Aidan-OS/Mochi40/Blender Files/Renders/Liquorice.png

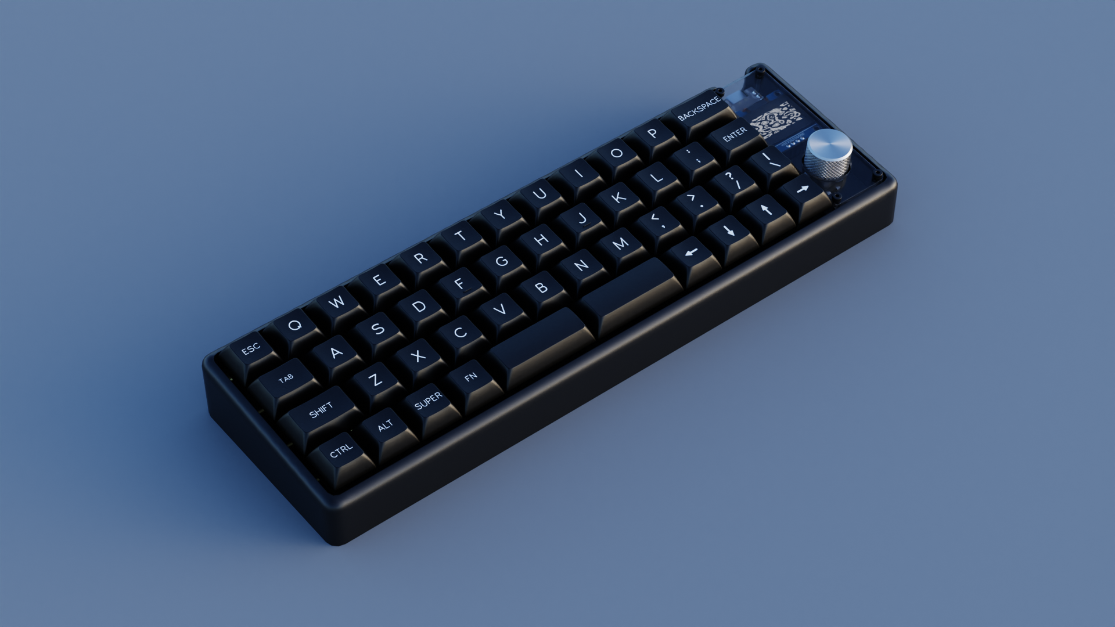
Blender Files/Renders/Liquorice.png
