Aidan-OS/Mochi40/Blender Files/Renders/Matcha.png

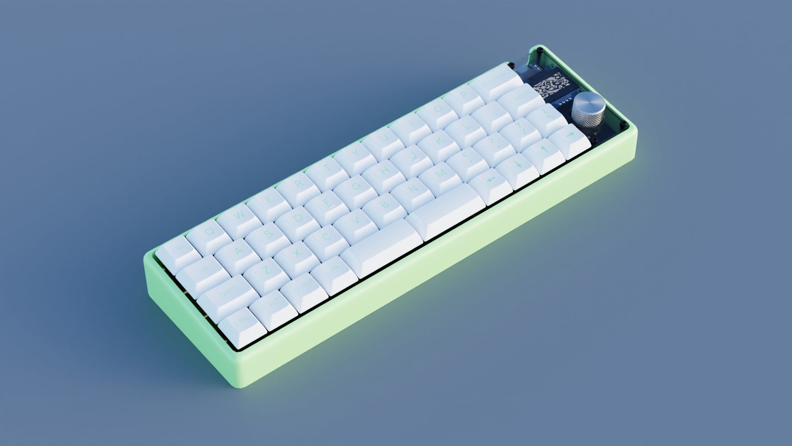
Blender Files/Renders/Matcha.png
