Aidan-OS/Mochi40/ic.md

Subject: Mochi40: A Burger Mounted 40% with a Knob, OLED, and optional Bluetooth

[font=arial][center][size=14pt]Hello Geekhack, today I present you the[/size]
[color=purple][size=36pt]Mochi40[/size][/color]

[img]https://i.imgur.com/1u3vPoi.png[/img]
Mochi40 (Taro Colourway)

[size=18pt][color=red][b]Disclaimer:[/b][/color][/size]
[size=12pt]The Mochi40 is based off of the Whimsy, a board designed by Prkns that was meant to go into group buy around a year ago. After Prkns went silent for almost 4 months, I began to reverse engineer the Whimsy through the renders and the files publicly available on GitHub. After building a small following on the ThisIsFourteen server, I moved to my own server and began to differentiate my project from the Whimsy. Additionally, all the files I have created are publicly available on GitHub under a permissible license to keep with the open source nature of the project: [url]https://github.com/Aidan-OS/Mochi40[/url]

Prkns still hasn't directly communicated with his community, however one of his moderators has communicated for him stating that he does not know when he will be able to return to the world of keyboards. As a result I continued to develop the Mochi40.

How does the Mochi40 differentiate itself from the Whimsy? Well, the title of the post gives some of it away, but let's get into it![/size]

[color=purple][size=18pt]Case Material and Colours[/size][/color]

[size=12pt]The Mochi40 will be made of 6063 aluminum and exclusively treated with Cerakote. There are currently 8 colour options shown below. I am in close contact with my coating shop and have confirmed that all of these colours will be okay to do, provided a minimum order of 10 per colour. If I get very little to no interest on a colour it will be dropped, but other than that all these colours will be run. Additionally, I am in midst of working with the shop to get basic prototype testing of each of the mixed colours on scrap material.[/size]

[img]https://i.imgur.com/1u3vPoi.png[/img] [img]https://i.imgur.com/ApZ9prn.png[/img]
Taro (Bright Purple + Stormtrooper White mix)                                                                                       Butterfly Tea (It's a Boy Blue)
[img]https://i.imgur.com/UucUkbZ.png[/img] [img]https://i.imgur.com/Sz2EtNh.png[/img]
Liquorice (Blackout Black)                                                                                                 Matcha (Mojito Green + Stormtrooper White mix)
[img]https://i.imgur.com/DThFcTM.png[/img] [img]https://i.imgur.com/qVN6Caj.png[/img]
Plain (Stormtrooper White)                                                                                                                   Red Bean (Crimson)
[img]https://i.imgur.com/2JMorvx.png[/img] [img]https://i.imgur.com/JZZRiYR.png[/img]
Strawberry (Bazooka Pink)                                                                                                       Waterdrop (Ceramic High Gloss Clear)

[color=purple][size=18pt]Plate Materials [/size][/color]

[size=12pt]Currently I am confident in offering FR4, PC, POM, and aluminum plates. I have done work to find a place which will provide brass plates at a reasonable price, however have been out of luck. Brass is still included on the IC, however unless there is a considerable amount of interest in it (and people are willing to pay a premium) I will not be offering brass.[/size]

[color=purple][size=18pt]PCB & Layout[/size][/color]

[size=12pt]The core of the Mochi40 is the fine!40 PCB. There will be two options for the fine!40 rev1, a soldered and a hotswap version.

The soldered version of the PCB will require you to solder everything: the diodes, the microcontroller, the OLED, the rotary encoder, the reset button, and the switches.

The hotswap version will still require you to solder the microcontroller, OLED, the reset button, and Rotary Encoder, but not the diodes and switches.

Below is an image featuring the available layouts on the fine!40 soldered PCB. As for the Hotswap PCB, the only available layout will be L1. I am currently considering switching L1 to be 2.25u + 2.75u, so that is included on the IC.[/size]

[img]https://i.imgur.com/CSch6fS.png[/img]
Mochi40 Layout Options

[color=purple][size=18pt]Microcontrollers, OLEDs, & Firmware[/size][/color]

[size=12pt]The fine!40 pcb is capable of functioning with two different microcontrollers, the nice!nano and the Elite-C. I will be providing both as options at group buy time, with the nice!nano being slightly more expensive and including a JST header for your battery. Doing things in this manner allows for me to offer a bluetooth upgrade at as low of a cost as possible.

I will be offering two different sizes of SSD1306 OLED at the time of the group buy, 128x64 and 32x6, both with white lighting. 

As for firmware, the Elite-C version will use QMK, while the nice!nano will use ZMK.[/size]

[color=purple][size=18pt]Purchase Options[/size][/color]
[size=12pt]I really wish I could work out a way to make this less complicated of a breakdown, but I just can't. There will be two core purchasing options, the Mochi40 Kit and the fine!40 PCB.[/size]

[size=12pt]
[u]Mochi40 Kit[/u]
[i]Required Parts[/i]
1 x Aluminum Case (any colour)
1 x fine!40 PCB (Soldered or Hotswap)
1 x Core electronics kit (diodes, rotary encoder, reset button)
1 x Core mounting kit (screws, 50A Silicone o-rings)
1 x OLED (128x64, 128x32)
1 x Microcontroller (Elite-C or nice!nano)
1 x Acrylic Screen Cover

[i]Optional Parts[/i]
1 x Plate & Plate Foam (yes this can be built plateless)
1 x JST battery connector (for nice!nano)

[u]fine!40 PCB[/u]
[i]Required Parts[/i]
1 x fine!40 PCB (Soldered or Hotswap)
1 x Core electronics kit (diodes, rotary encoder, reset button)
1 x Microcontroller (Elite-C or nice!nano)
1 x Core mounting kit (screws, 50A Silicone o-rings)
1 x OLED (128x64, 128x32)
1 x Acrylic Screen Cover
 
[i]Optional Parts[/i]
1 x JST Battery connector
1 x Plastic mounting kit (Threaded inserts for 3D printed cases)

[u]Extra Parts for Individual Purchase[/u]
- All plates
- Extra Microcontrollers
- Extra Acrylic Screen Covers
- Extra OLED Screens
- Plate Foam
[/size]

[color=purple][size=18pt]Vendors and Pricing[/size][/color]
[size=12pt]NA: Me (Located in Toronto, Canada)
UK: Protozoa
EU: CandyKeys
AUS: Allcaps
SEA: Hex Keyboards
India: TBD
Japan: TBD

Pricing per vendor differs more than just the currency conversion. This is due to the costs associated with vendors. If you are ordering from an area where a vendor sells, you are going to save money on shipping and taxes as a result.

[img]https://i.imgur.com/znM21WO.jpg[/img]
[/size]

[color=purple][size=18pt]Prototype(s)[/size][/color]
[size=12pt]In this day and age you can't really come to GH without a prototype it seems, so I have done so. My first prototype is of a slightly older case design with the only major change being the removal of the center screw post.

[img]https://i.imgur.com/uzo8PA6.jpg[/img] [img]https://i.imgur.com/0qNttD1.jpg[/img] [img]https://i.imgur.com/8msYtKK.jpg[/img]

[img]https://i.imgur.com/kVi3sCo.jpg[/img] [img]https://i.imgur.com/WfhExhh.jpg[/img] [img]https://i.imgur.com/Sc0cegF.jpg[/img]

The prototype definitely has some issues to address, all of which should be fixed in the second prototype I am currently having made. First, there are some small holes in the bottom of the case as a result of tolerance issues. Second there is clear ringing on some of the outside edges of the case which will not be present in the final versions by adding another finishing pass. Finally, there are two spots where the coating is rough as a result of the hanger rubbing against the board while drying. This will be solved with a custom drying rig for the final product.

One more thing to comment on is the thin coating on bottom inside edges of the case. This is a result of an intentional cost cutting measure that has been done to bring the board out for a lower price. This thinner coating will only be present on the bottom inside of the case (where it is not visible when built).[/size]

[color=purple][size=18pt]My Thanks to the Community[/size][/color]
[size=12pt]I have a large list of people to say thanks to as a result of the fantastic support that I have gotten from many discords. Heck, I wouldn't be here if it weren't for the OGs on my discord server who have been helping every step of the way with feedback and design input. They pushed me to turn this into a full project instead of just making a Whimsy for myself. Please note that this list of thanks is in absolutely no order:

Bomtarnes from the QMK Discord
Filterpaper from the QMK Discord
Drashna from the QMK Discord
Dan from RingerKeys
Pete Johanson of ZMK
BraveKarma of the ZMK Discord
Maple Computing of the Elite-C Project
Nick of Nice Keyboards
Ecto of Protozoa
MakerJake
FreshFromTheGrave
JC of Allcaps
David of CandyKeys
Jaspertandy of Fourteen
Prkns of Fourteen
Everyone on the AidanSmith.dev Discord
[/size]
[size=24pt]
[URL=https://forms.gle/RMZY9wcHToaioVtB6]Interest Check Form[/URL]
[URL=https://discord.gg/kkPBkA3x4q]Discord[/URL]
[/size]
[/center]
