Aidan-OS/Mochi40/Blender Files/Renders/Jpgs/Plain.jpg

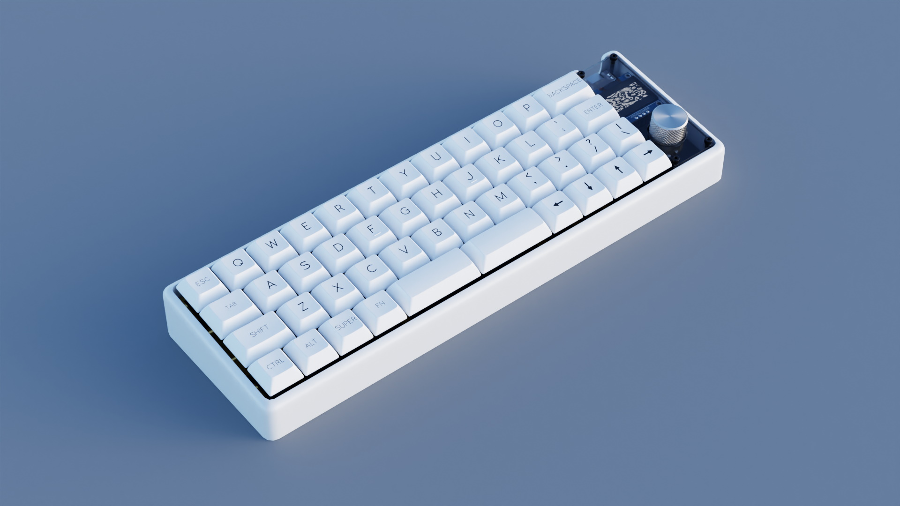
Blender Files/Renders/Jpgs/Plain.jpg
