Aidan-OS/Mochi40/Blender Files/Renders/Jpgs/Red Bean.jpg

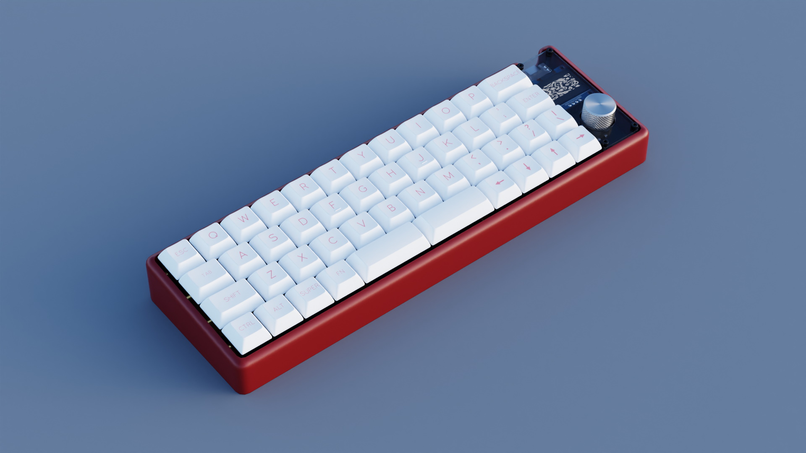
Blender Files/Renders/Jpgs/Red Bean.jpg
