Aidan-OS/Mochi40/Blender Files/Renders/Jpgs/Strawberry.jpg

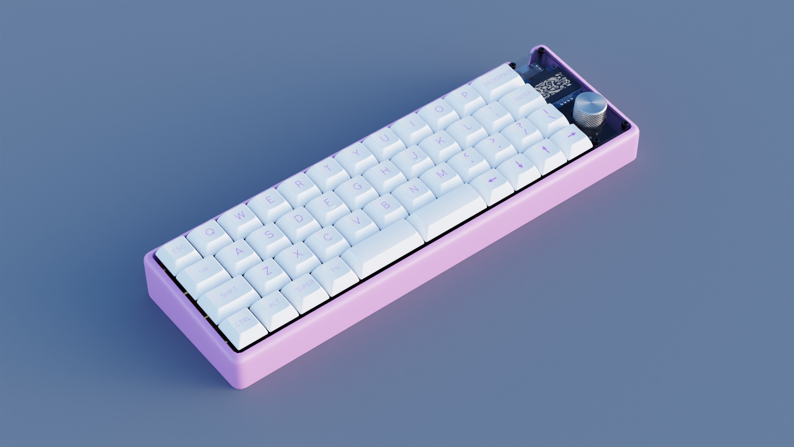
Blender Files/Renders/Jpgs/Strawberry.jpg
