Aidan-OS/Mochi40/Blender Files/Renders/Jpgs/Taro.jpg

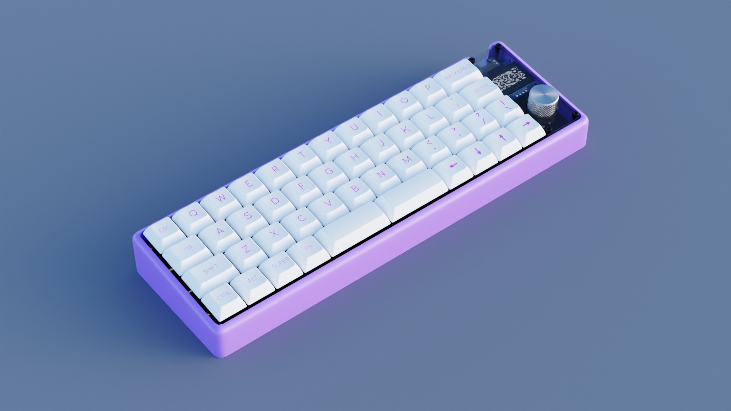
Blender Files/Renders/Jpgs/Taro.jpg
