Aidan-OS/Mochi40/Blender Files/Renders/Jpgs/Tea + Taro.jpg

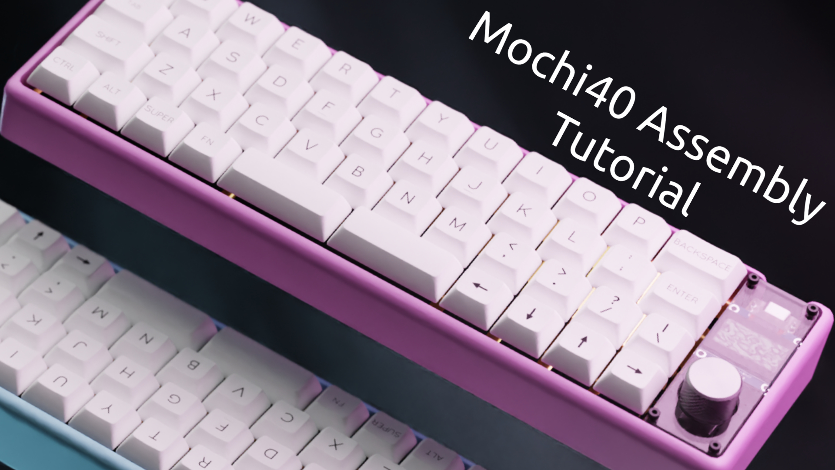
Blender Files/Renders/Jpgs/Tea + Taro.jpg
