Aidan-OS/Mochi40/Blender Files/Renders/Jpgs/Waterdrop.jpg

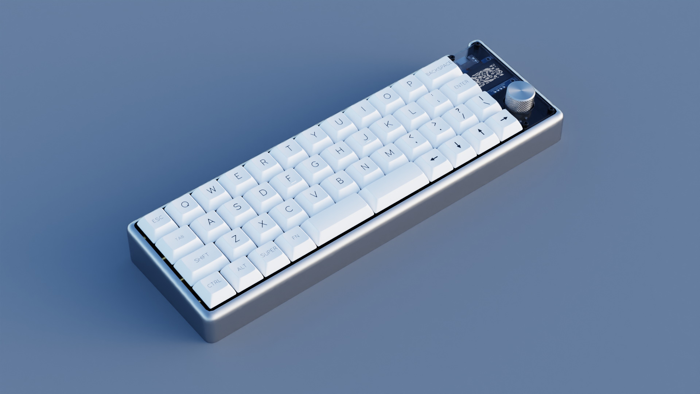
Blender Files/Renders/Jpgs/Waterdrop.jpg
