Aidan-OS/Mochi40/Blender Files/Renders/Tea + Taro.png

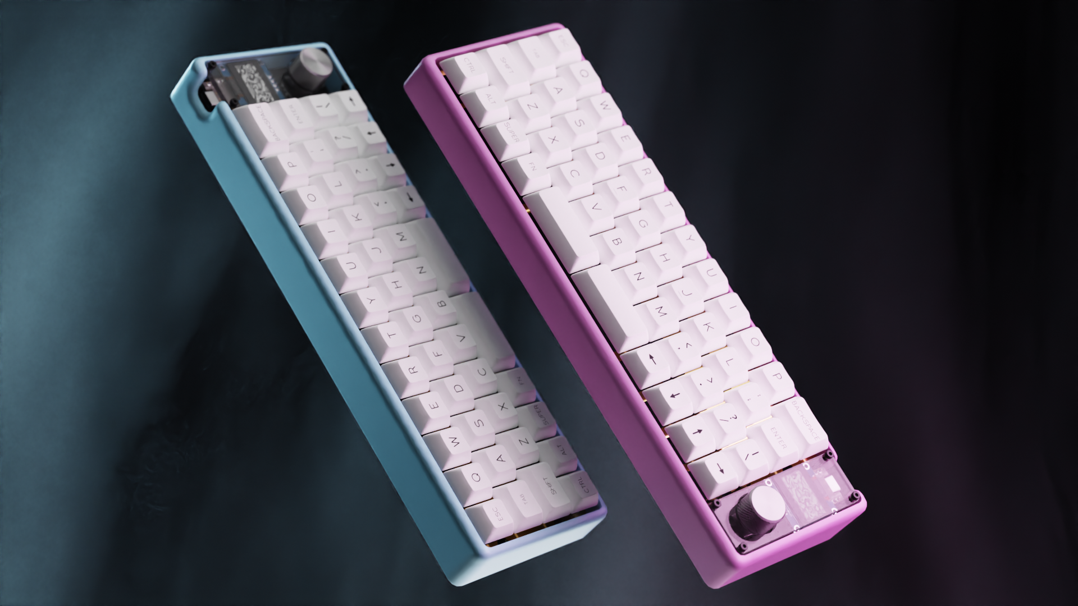
Blender Files/Renders/Tea + Taro.png
