Aidan-OS/Mochi40/Blender Files/Renders/Waterdrop.png

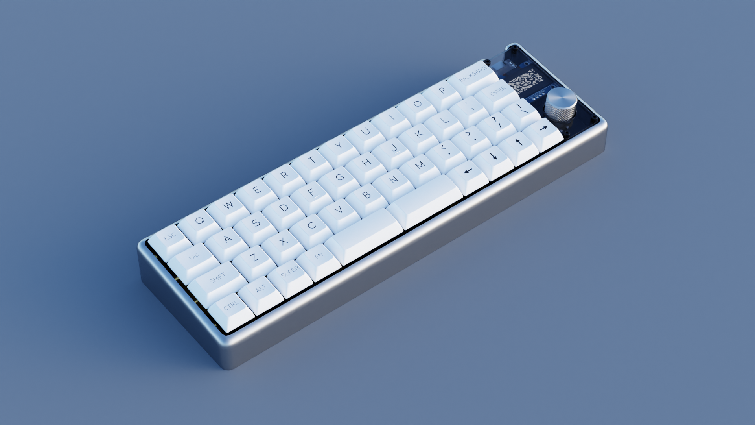
Blender Files/Renders/Waterdrop.png
