Aidan-OS/Mochi40/Images/Layout.png

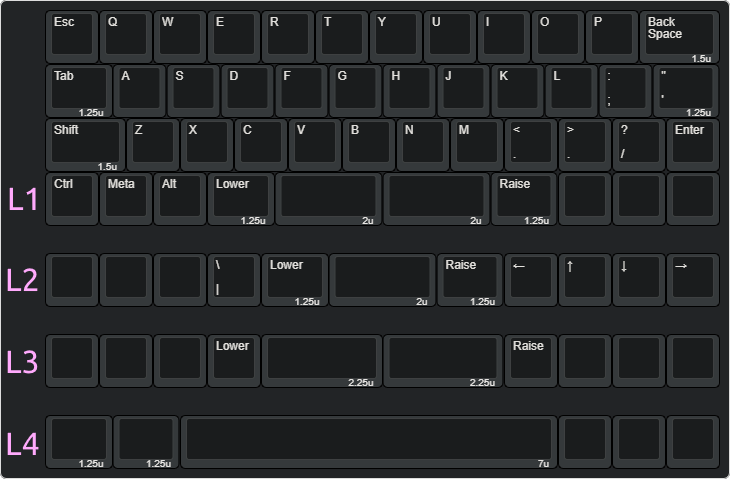
Images/Layout.png
