Aidan-OS/Mochi40/Case/NewCase.STL

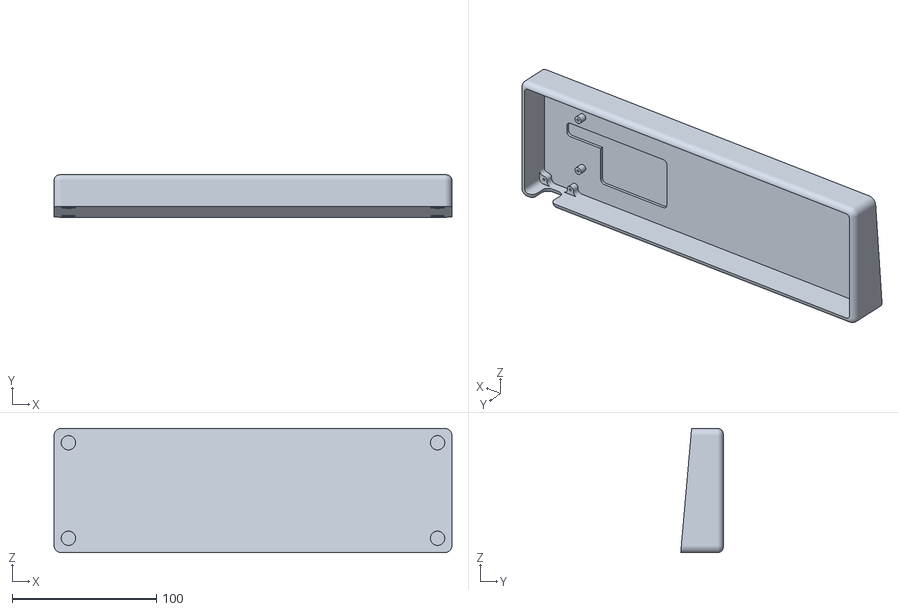
[picture p12: CAD file, 2022-06-19]
Case/NewCase.STL
276.1 x 29.5 x 86.2
