Aidan-OS/Mochi40/PCB/3D Files/Hotswap PCB.step

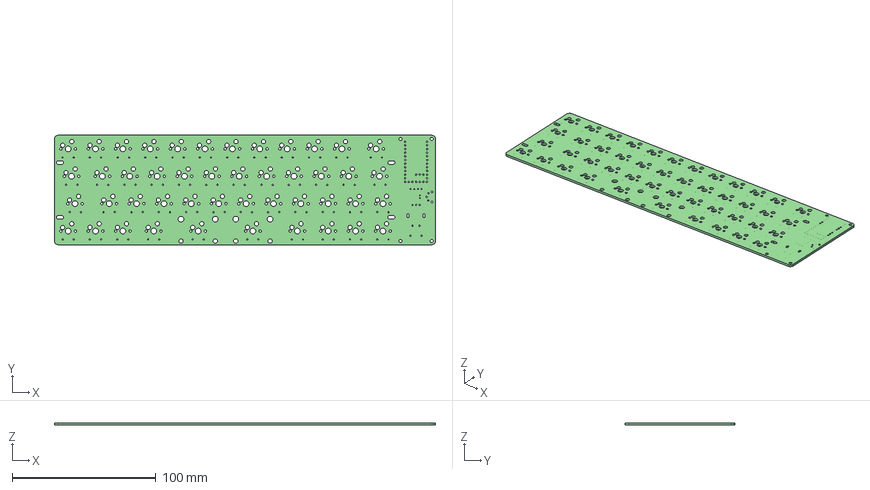
[picture p13: CAD file, 2021-12-15]
PCB/3D Files/Hotswap PCB.step
265.1 x 76.2 x 1.60 mm
