Aidan-OS/Mochi40/Case/SmallTest.STL

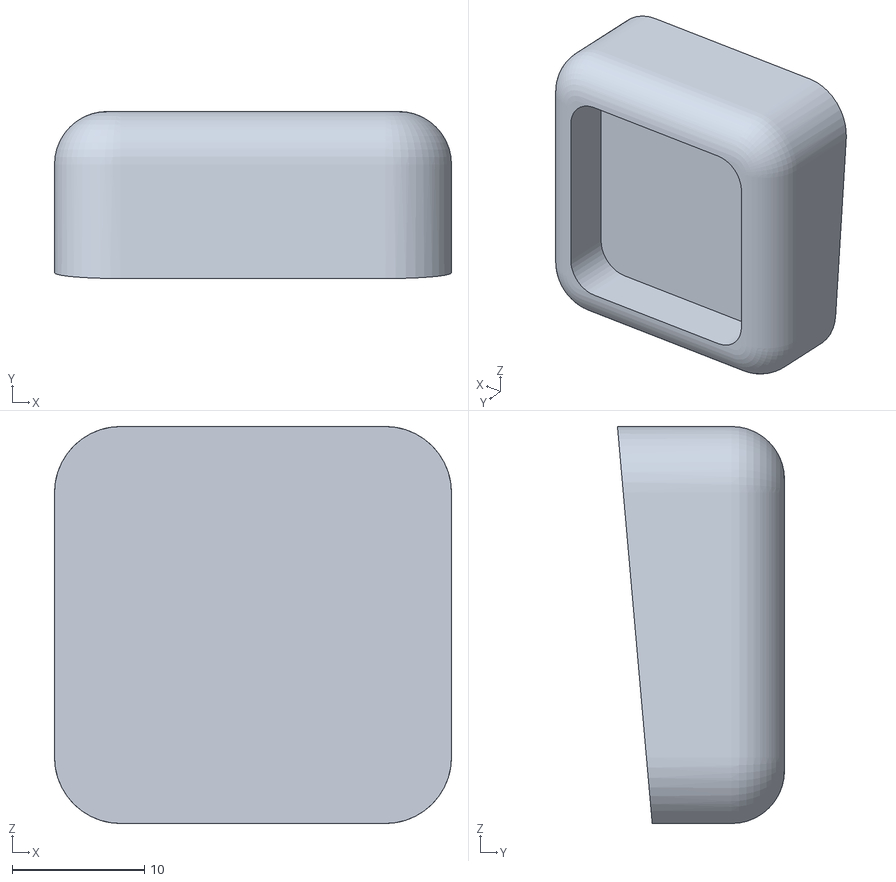
[picture p14: CAD file, 2022-06-19]
Case/SmallTest.STL
30.0 x 12.6 x 30.0
