Aidan-OS/Mochi40/Plate/Plate.SLDPRT

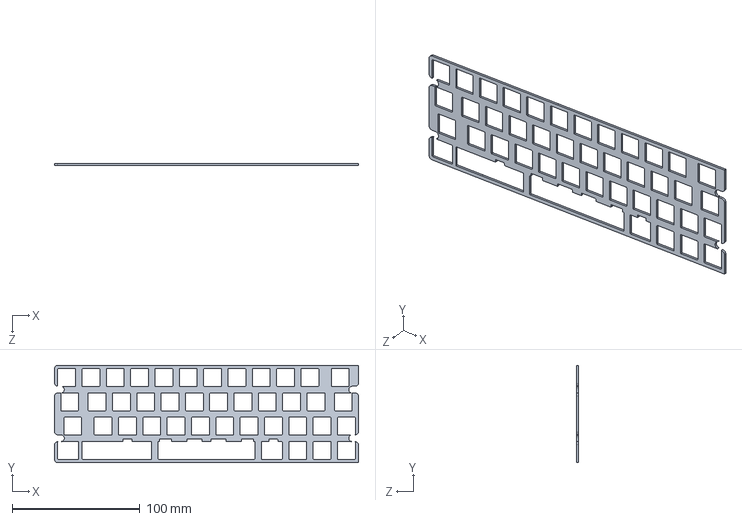
[picture p15: CAD file, 2021-12-13]
Plate/Plate.SLDPRT
238.1 x 76.2 x 1.50 mm
