Aidan-OS/Mochi40/Case/Case Foam.DXF

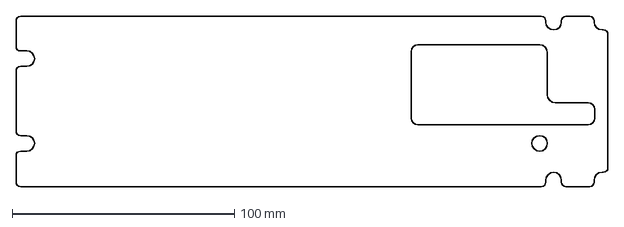
[picture p16: CAD file, 2022-06-19]
Case/Case Foam.DXF
266.1 x 76.5 mm
