Aidan-OS/Mochi40/Case/Acrylic Cover.DXF

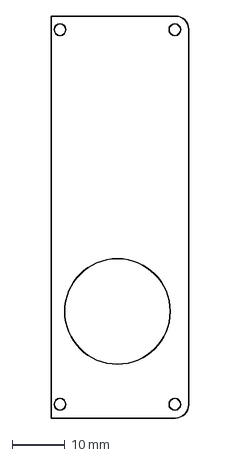
[picture p17: CAD file, 2022-01-25]
Case/Acrylic Cover.DXF
26.0 x 76.2 mm
