Aidan-OS/Mochi40/Case/3D Print Case.STL

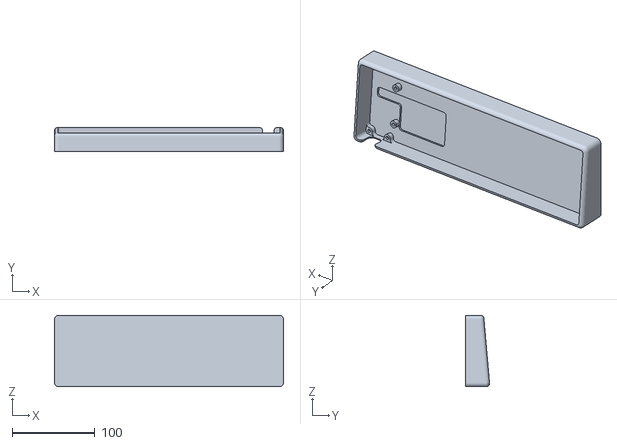
[picture p18: CAD file, 2022-01-08]
Case/3D Print Case.STL
276.1 x 29.2 x 86.2
