Aidan-OS/Mochi40/Assembly/1173N004_High-Temperature Soft Silicone O-Ring.SLDPRT

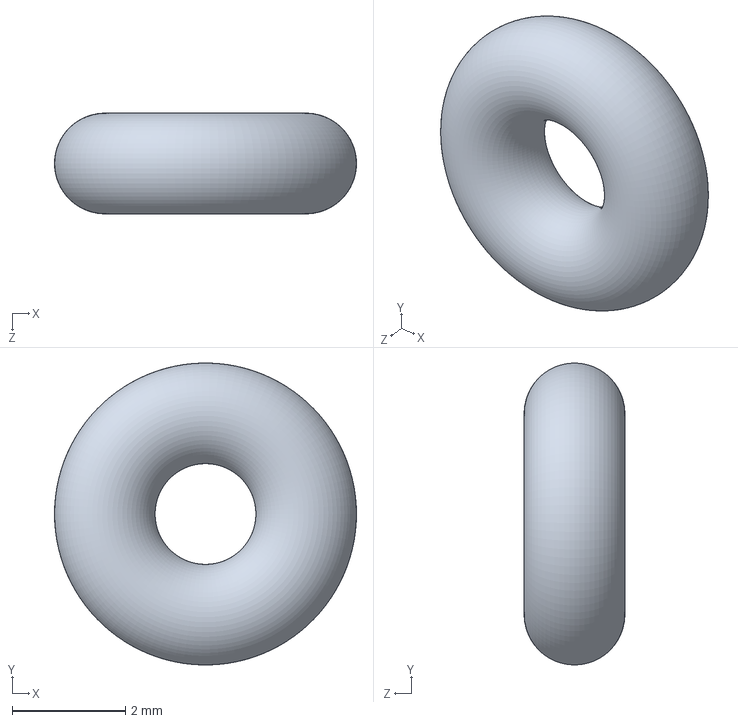
[picture p19: CAD file, 2021-12-07]
Assembly/1173N004_High-Temperature Soft Silicone O-Ring.SLDPRT
5.33 x 5.33 x 1.78 mm
