Aidan-OS/Mochi40/Plate/Plate (Screw Holes).DXF

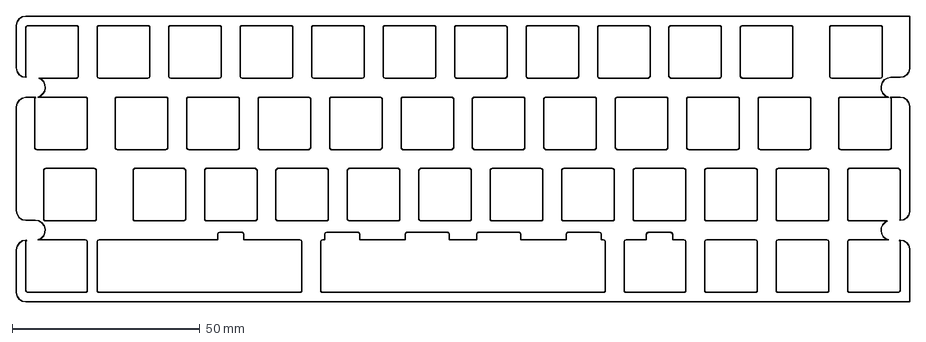
[picture p20: CAD file, 2021-12-13]
Plate/Plate (Screw Holes).DXF
238.1 x 76.2 mm
