Aidan-OS/Mochi40/Assembly/91290A047_Black-Oxide Alloy Steel Socket Head Screw (16mm).SLDPRT

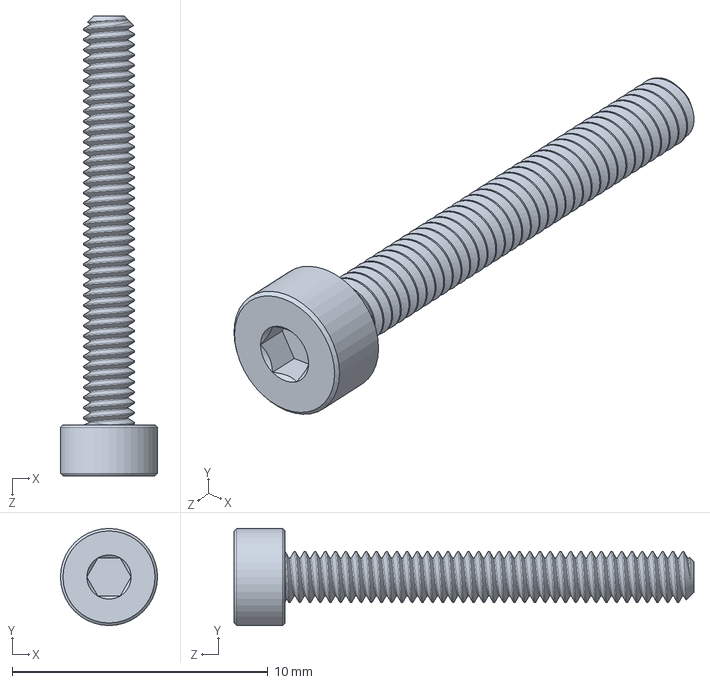
[picture p21: CAD file, 2021-12-07]
Assembly/91290A047_Black-Oxide Alloy Steel Socket Head Screw (16mm).SLDPRT
3.80 x 3.80 x 18.0 mm
