Aidan-OS/Mochi40/Assembly/91290A012_Black-Oxide Alloy Steel Socket Head Screw (5mm).SLDPRT

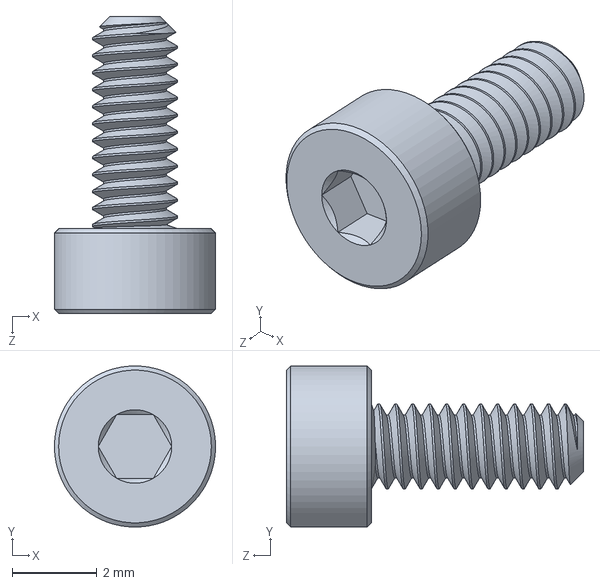
[picture p22: CAD file, 2021-12-07]
Assembly/91290A012_Black-Oxide Alloy Steel Socket Head Screw (5mm).SLDPRT
3.80 x 3.79 x 7.00 mm
