Aidan-OS/Mochi40/Plate/Plate (No Screw Holes).dxf

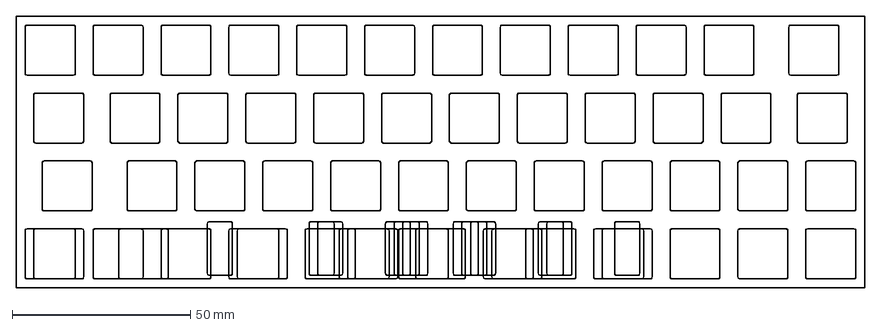
[picture p23: CAD file, 2021-12-07]
Plate/Plate (No Screw Holes).dxf
238.1 x 76.2 mm
