Aidan-OS/Mochi40/(list of files, cad)

Other CAD files:
PCB/3D Files/Solder PCB.step
