Aidan-OS/Mochi40/PCB/Hotswap PCB.kicad_pcb

## KiCad design PCB/Hotswap PCB.kicad_pcb (2022-06-22)

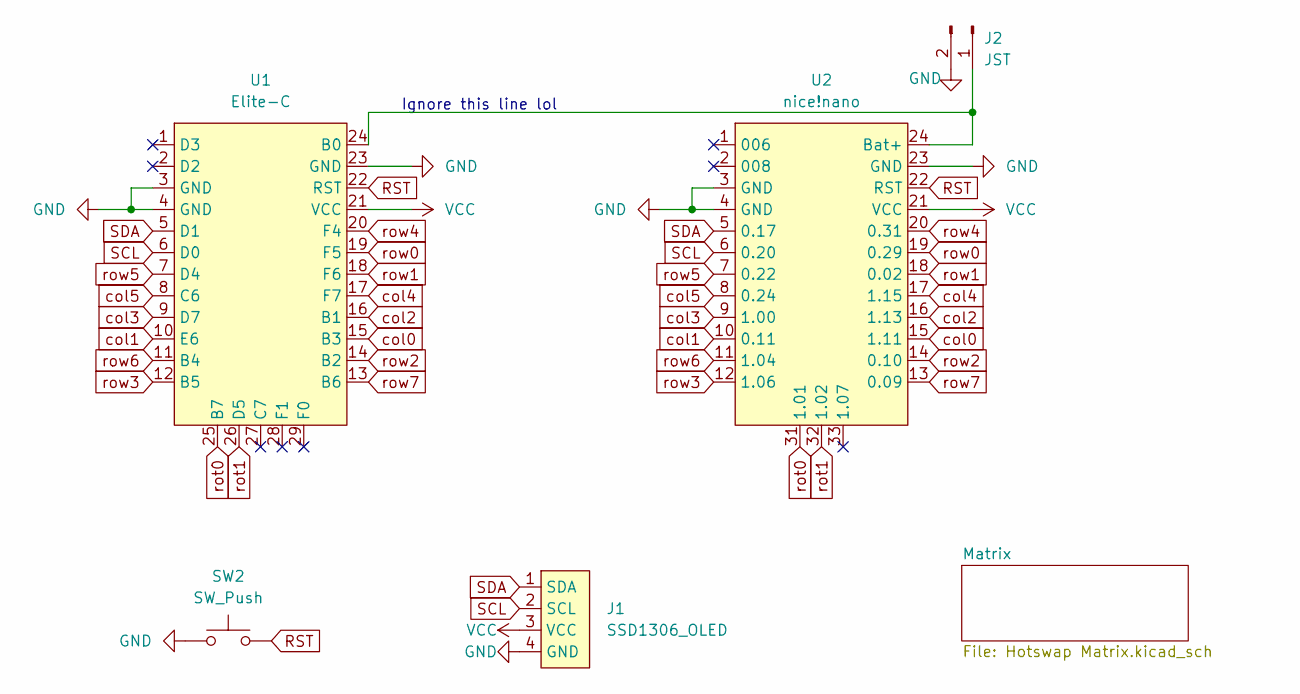
[picture p24: schematic Hotswap PCB.kicad_sch]

Parts:
J1: SSD1306_OLED; OLED_v2
J2: JST; JST_PH_S2B-PH-K_1x02_P2.00mm_Horizontal
SW2: SW_Push; SW_Tactile_SPST_Angled_MJTP1117
U1: Elite-C
U2: nice!nano; nice_nano

Connections:
GND: J1.4 (GND), J2.2, SW2.1, U1.3 (GND), U1.4 (GND), U1.23 (GND), U2.3 (GND), U2.4 (GND), U2.23 (GND); also elsewhere on the board
unnamed: J2.1, U1.24 (B0), U2.24 (Bat+)
RST: SW2.2, U1.22 (RST), U2.22 (RST)
SCL: J1.2 (SCL), U1.6 (D0), U2.6 (0.20)
SDA: J1.1 (SDA), U1.5 (D1), U2.5 (0.17)
VCC: J1.3 (VCC), U1.21 (VCC), U2.21 (VCC)
col0: U1.15 (B3), U2.15 (1.11); also elsewhere on the board
col1: U1.10 (E6), U2.10 (0.11); also elsewhere on the board
col2: U1.16 (B1), U2.16 (1.13); also elsewhere on the board
col3: U1.9 (D7), U2.9 (1.00); also elsewhere on the board
col4: U1.17 (F7), U2.17 (1.15); also elsewhere on the board
col5: U1.8 (C6), U2.8 (0.24); also elsewhere on the board
rot0: U1.25 (B7), U2.31 (1.01); also elsewhere on the board
rot1: U1.26 (D5), U2.32 (1.02); also elsewhere on the board
row0: U1.19 (F5), U2.19 (0.29); also elsewhere on the board
row1: U1.18 (F6), U2.18 (0.02); also elsewhere on the board
row2: U1.14 (B2), U2.14 (0.10); also elsewhere on the board
row3: U1.12 (B5), U2.12 (1.06); also elsewhere on the board
row4: U1.20 (F4), U2.20 (0.31); also elsewhere on the board
row5: U1.7 (D4), U2.7 (0.22); also elsewhere on the board
row6: U1.11 (B4), U2.11 (1.04); also elsewhere on the board
row7: U1.13 (B6), U2.13 (0.09); also elsewhere on the board

Notes on the sheet:
Ignore this line lol

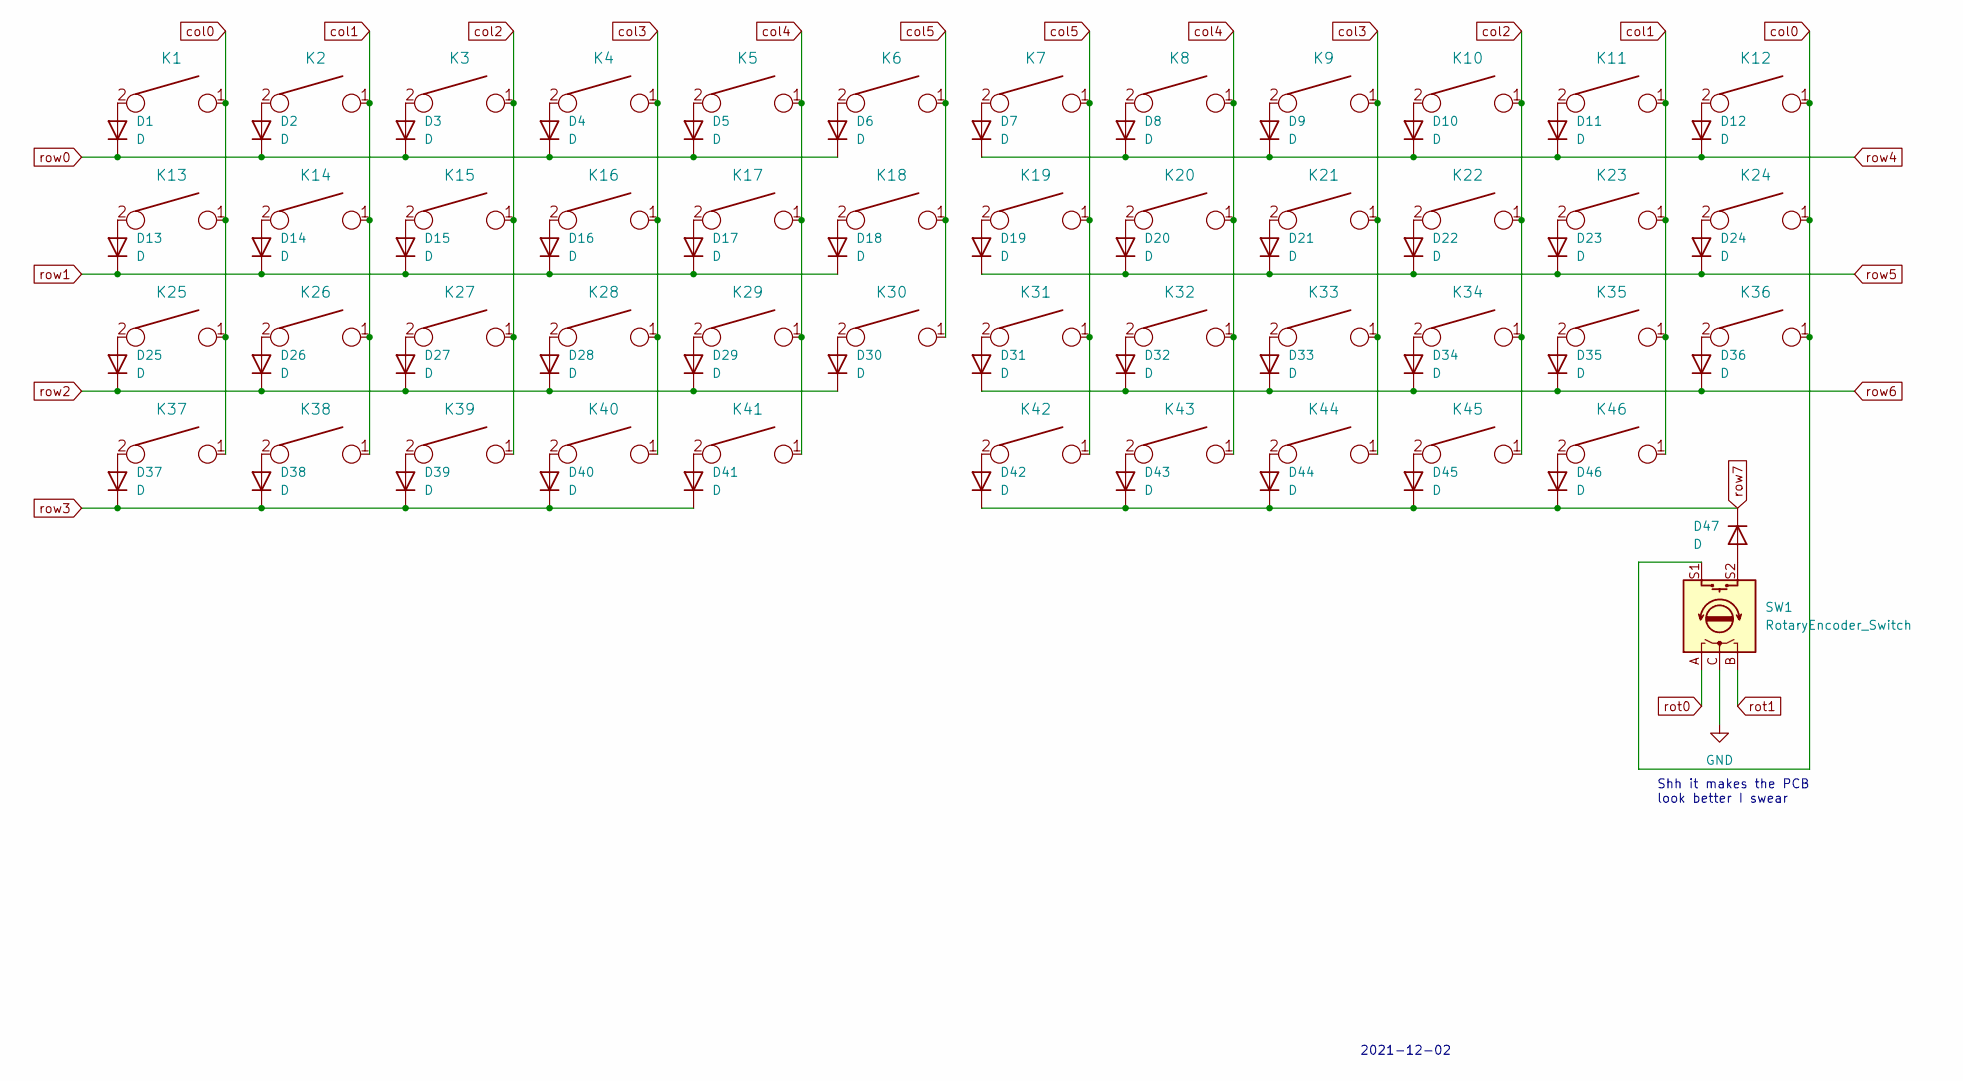
[picture p25: schematic Hotswap Matrix.kicad_sch]

Parts:
D1, D2, D3, D4, D5, D6, D7, D8, D9, D10, D11, D12, D13, D14, D15, D16, D17, D18, D19, D20, D21, D22, D23, D24, D25, D26, D27, D28, D29, D30, D31, D32, D33, D34, D35, D36, D37, D38, D39, D40, D41, D42, D43, D44, D45, D46, D47: D; Diode-Hybrid-Back
K1, K2, K3, K4, K5, K6, K7, K8, K9, K10, K11, K14, K15, K16, K17, K18, K19, K20, K21, K22, K23, K26, K27, K28, K29, K30, K31, K32, K33, K34, K35, K36, K37, K38, K39, K40, K43, K44, K45, K46: KEYSW; MXOnly-1U-NoLED
K12, K25: KEYSW; MXOnly-1.5U-NoLED
K13, K24, K41, K42: KEYSW; MXOnly-1.25U-NoLED
SW1: RotaryEncoder_Switch; RotaryEncoder_Alps_EC11E-Switch_Vertical_H20mm

Connections:
GND: SW1.C; also elsewhere on the board
unnamed: D1.2 (A), K1.2
unnamed: D2.2 (A), K2.2
unnamed: D3.2 (A), K3.2
unnamed: D4.2 (A), K4.2
unnamed: D5.2 (A), K5.2
unnamed: D6.2 (A), K6.2
unnamed: D7.2 (A), K7.2
unnamed: D8.2 (A), K8.2
unnamed: D9.2 (A), K9.2
unnamed: D10.2 (A), K10.2
unnamed: D11.2 (A), K11.2
unnamed: D12.2 (A), K12.2
unnamed: D13.2 (A), K13.2
unnamed: D14.2 (A), K14.2
unnamed: D15.2 (A), K15.2
unnamed: D16.2 (A), K16.2
unnamed: D17.2 (A), K17.2
unnamed: D18.2 (A), K18.2
unnamed: D19.2 (A), K19.2
unnamed: D20.2 (A), K20.2
unnamed: D21.2 (A), K21.2
unnamed: D22.2 (A), K22.2
unnamed: D23.2 (A), K23.2
unnamed: D24.2 (A), K24.2
unnamed: D25.2 (A), K25.2
unnamed: D26.2 (A), K26.2
unnamed: D27.2 (A), K27.2
unnamed: D28.2 (A), K28.2
unnamed: D29.2 (A), K29.2
unnamed: D30.2 (A), K30.2
unnamed: D31.2 (A), K31.2
unnamed: D32.2 (A), K32.2
unnamed: D33.2 (A), K33.2
unnamed: D34.2 (A), K34.2
unnamed: D35.2 (A), K35.2
unnamed: D36.2 (A), K36.2
unnamed: D37.2 (A), K37.2
unnamed: D38.2 (A), K38.2
unnamed: D39.2 (A), K39.2
unnamed: D40.2 (A), K40.2
unnamed: D41.2 (A), K41.2
unnamed: D42.2 (A), K42.2
unnamed: D43.2 (A), K43.2
unnamed: D44.2 (A), K44.2
unnamed: D45.2 (A), K45.2
unnamed: D46.2 (A), K46.2
unnamed: D47.2 (A), SW1.S2
col0: K1.1, K12.1, K13.1, K24.1, K25.1, K36.1, K37.1, SW1.S1; also elsewhere on the board
col1: K2.1, K11.1, K14.1, K23.1, K26.1, K35.1, K38.1, K46.1; also elsewhere on the board
col2: K3.1, K10.1, K15.1, K22.1, K27.1, K34.1, K39.1, K45.1; also elsewhere on the board
col3: K4.1, K9.1, K16.1, K21.1, K28.1, K33.1, K40.1, K44.1; also elsewhere on the board
col4: K5.1, K8.1, K17.1, K20.1, K29.1, K32.1, K41.1, K43.1; also elsewhere on the board
col5: K6.1, K7.1, K18.1, K19.1, K30.1, K31.1, K42.1; also elsewhere on the board
rot0: SW1.A; also elsewhere on the board
rot1: SW1.B; also elsewhere on the board
row0: D1.1 (K), D2.1 (K), D3.1 (K), D4.1 (K), D5.1 (K), D6.1 (K); also elsewhere on the board
row1: D13.1 (K), D14.1 (K), D15.1 (K), D16.1 (K), D17.1 (K), D18.1 (K); also elsewhere on the board
row2: D25.1 (K), D26.1 (K), D27.1 (K), D28.1 (K), D29.1 (K), D30.1 (K); also elsewhere on the board
row3: D37.1 (K), D38.1 (K), D39.1 (K), D40.1 (K), D41.1 (K); also elsewhere on the board
row4: D7.1 (K), D8.1 (K), D9.1 (K), D10.1 (K), D11.1 (K), D12.1 (K); also elsewhere on the board
row5: D19.1 (K), D20.1 (K), D21.1 (K), D22.1 (K), D23.1 (K), D24.1 (K); also elsewhere on the board
row6: D31.1 (K), D32.1 (K), D33.1 (K), D34.1 (K), D35.1 (K), D36.1 (K); also elsewhere on the board
row7: D42.1 (K), D43.1 (K), D44.1 (K), D45.1 (K), D46.1 (K), D47.1 (K); also elsewhere on the board

Notes on the sheet:
2021-12-02
Shh it makes the PCB look better I swear

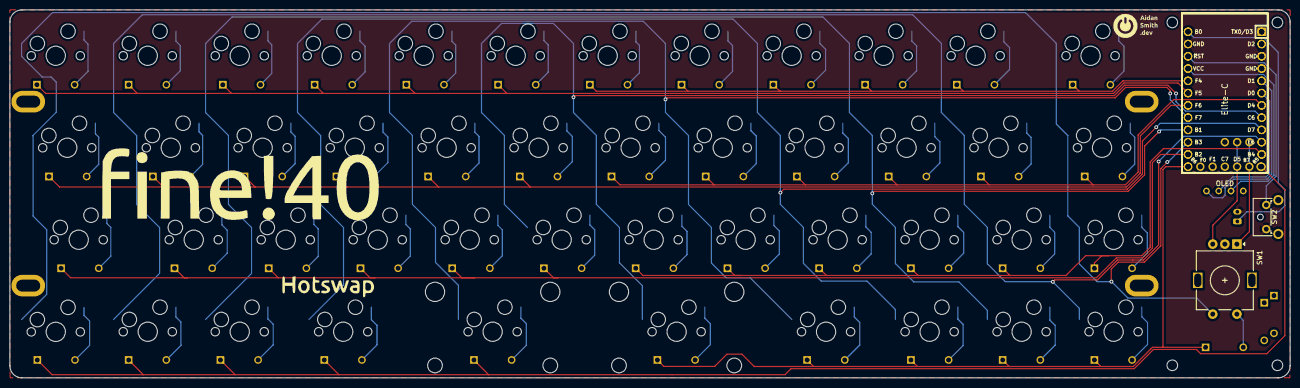
[picture p26: board Hotswap PCB.kicad_pcb from above]

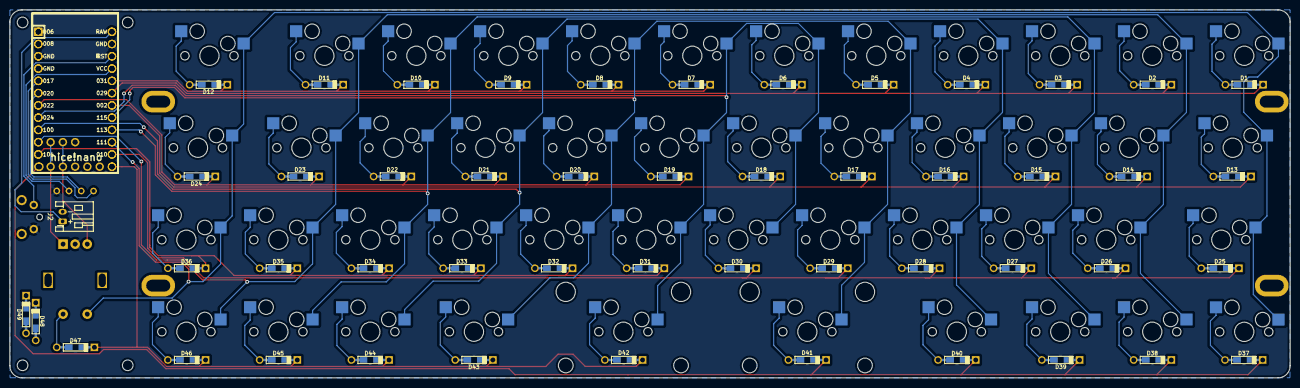
[picture p27: board Hotswap PCB.kicad_pcb from below]

Board: 2 copper layers, 265.1 x 76.2 mm, 109 parts (3 on the bottom side), 69 nets.

Other parts of the board:
Acryl Mount: MountingHole_2.2mm_M2
Acryl Mount#2, Acryl Mount#3, Acryl Mount#4: MountingHole_2.2mm_M2
D48, D49: D; Diode-Hybrid-Back
Mnt: PKRH
Mnt#2, Mnt#3, Mnt#4: PKRH
