Aidan-OS/Mochi40/(commit log)

2021-12-07 Made a single mate to test discord integration
    [Assembly.SLDASM]
2021-12-10 Added QMK Firmware, added files needed for blender renders
    [Assembly.SLDASM, CNC Case.SLDPRT, Hotswap PCB.kicad_pcb, PCB.kicad_pcb, PCB.step, Plate.SLDPRT]
2021-12-10 Added acrylic cover and the blender model for it
    [Acrylic Cover.SLDPRT]
2021-12-11 Fixed plate.wrl and acrylic cover.wrl from being broken (why solidworks)
2021-12-13 Fixed a problem PCB Matrixes not being seperate. Uploaded somewhat broken ZMK firmware
    [Acrylic Cover.SLDPRT, Hotswap Matrix.kicad_sch, Hotswap PCB.kicad_sch, PCB.kicad_sch, Plate (Screw Holes).DXF, Plate.SLDPRT]
2021-12-15 prepared files for final send to PCBWay
    [Hotswap PCB.kicad_pcb, Hotswap PCB.step, PCB.kicad_pcb, PCB.step, Solder PCB.step, plate.kicad_pcb, plate.kicad_sch]
2021-12-30 Added battery hole to CNC case. Fixed odd linkages with kicad files. General firmware updates
    [CNC Case.SLDPRT, Hotswap Matrix.kicad_sch, Hotswap PCB.kicad_pcb, Hotswap PCB.kicad_sch]
2022-01-08 Removed revision naming on PCB, fixed info.json so it will now properly work, added VIA compatiblility, Updated renders slightly
    [Hotswap PCB.kicad_pcb, PCB.kicad_pcb]
2022-01-08 3D print case now exists
    [3D Print Case.SLDPRT, 3D Print Case.STL]
2022-01-25 Second revision for the IC
    [Acrylic Cover.DXF, Hotswap Matrix.kicad_sch, Hotswap PCB.kicad_pcb]
2022-02-22 Made changes to IC, slightly modified case file to deal with a tolerance issue present in the prototype
    [CNC Case.SLDPRT]
2022-02-22 Added submodules, fixed KiCad relative paths
2022-06-06 Added BOM
    [BOM.csv]
2022-06-06 BOM Didn't save for some reason
    [BOM.csv]
2022-06-06 Double screw up, missed i in a url
    [BOM.csv]
2022-06-19 Making sure all files are up to date
    [CNC Case.SLDPRT, Case Foam.DXF, Hotswap PCB.kicad_pcb, NewCase.SLDPRT, NewCase.STL, PCB.kicad_pcb, SmallTest.SLDPRT, SmallTest.STL]
2022-06-22 Removed a couple markings
    [Hotswap PCB.kicad_pcb, PCB.kicad_pcb]
2023-04-24 Removing all solidworks files
    [3D Print Case.SLDPRT, Acrylic Cover.SLDPRT, Assembly.SLDASM, CNC Case.SLDPRT, NewCase.SLDPRT, SmallTest.SLDPRT]
